BSidesCbr/BUSSide/(threads)

Thread 5 (2018-09-17):

No need to wait after Wire.requestFrom().

Koepel, 2018-09-17:
In the file "BUSSide/BUSSide/I2C.ino" the usage of `Wire.requestFrom()` and `Wire.available()` are used in a way as if `Wire.available()` waits for something.
The `Wire.requestFrom()` is blocking, it returns when the I2C transaction on the bus has finished. The `Wire.available()` returns the number of bytes in a buffer. There is no need to wait after the `Wire.requestFrom()`. This is the same for all Arduino Wire compatible libraries.
Explanation: [Common-mistakes#1](https://github.com/Koepel/How-to-use-the-Arduino-Wire-library/wiki/Common-mistakes#1)

About the function `read_I2C_eeprom()`:
The `ESP.wdtFeed();` is in the while-statement. But the `Wire.available()` and `Wire.read()` are fast. The `Wire.requestFrom()` is the one that takes time.

About the function `I2C_active_scan1()`:
When the `Wire.requestFrom()` does not return 8, the next slaveAddress is tested. The code after that (with the for-statement and the delay) is not really doing something, it falls through that code and executes the `ESP.wdtFeed();` and `numberOfSlaves++;`.

BSidesCbr, 2018-09-18:
Thank you. The fixes went in the last commit.

Closed 2018-09-18.

Thread 8 (2020-08-20):

Will this work on ESP32?

joanbono, 2020-08-20:
Just wondering if this will work on NodeMCU style board with WROOM32 chipset, which includes Bluetooth apart from WiFi.

Do you know if it’s compatible?

Thanks!

devec0, 2020-08-20:
I'm not sure it's been tested, and some of the GPIO names may need tweaking - but if it is supported by Arduino is could be made to work. If you have the board already, would be curious to see how you go compiling and uploading it with the ESP32 Arduino core.

joanbono, 2020-08-21:
I’m waiting for the board but I’ll look into it

devec0, 2022-02-09:
Going to close this for now but happy for a PR if you get it working.

Closed 2022-02-09.
