BSidesCbr/BUSSide/(commit log)

2018-04-14 Rename Hardware dir for compatibility with Arduino IDE
    The Arduino IDE requires sketches to be inside a folder with the same
    name as the sketch. The current directory name ("Hardware") causes an
    error on opening, and the IDE's default fix is to create a new dir and
    move only the BUSSide.ino file, breaking dependency file paths.
    [BUSSide.h, BUSSide.ino, I2C.ino, JTAG.ino, SPI.ino, UART.ino]
2018-08-25 Added UART tx detection and passhrough.
2018-08-25 NodeMCU code for UART passthrough and detection.
2018-08-26 New uart feature. Code cleanup.
    Moving code into bs.py
    uart passthrough auto is new command to combine the uart discovery and
    passthrough process.
2018-08-26 Fixup exception msg printing
    Correct printing
    [bs.py, bs_i2c.py, bs_jtag.py, bs_spi.py, bs_uart.py]
2018-08-26 i2c can do pinout discovery.
    New code to do i2c pinout discovery and do the other i2c functions with
    arbitrary GPIOs.
2018-09-17 I2C flashing and multi-size address support
    Add support for I2C flashing and allow multiple address sizes of 1 or 2
    bytes.
2018-09-18 New SPI features and I2C cleanup
    New features for SPI including pinout discovery, fuzzing/command
    enumeration, sending commands.
    Also bringing in code to prepare for writing to SPI flash.
    Fixing up a bug report by Koepel on incorrect use of available() in the
    I2C code.
    [BUSSide.h, BUSSide.ino, I2C.ino, SPI.ino, bs_spi.py, busside.py]
2018-09-20 Add more SPI support
    Support flashing via SPI. Also, a couple of extra commands such as read
    id, read unique id, and enable/disable write protection.
2018-09-24 Improve serial comms
    Non fixed size frames. Use a sync word. Improves reliability
    significantly.
    [BUSSide.h, BUSSide.ino, I2C.ino, JTAG.ino, SPI.ino, UART.ino, bs.py, bs_i2c.py]
2019-04-21 current arduiono ide doesn't like silvio's indents
    Arduino IDE ftbfs if function static property isn't on the same line
    as the function name.
    [BUSSide.ino, I2C.ino, JTAG.ino, SPI.ino, UART.ino]
2019-06-28 Changed shebang to portable python2
    When running newer distros that bundle python3 by default running './busside.py' will error out as it expects python3 code.
    Specifying the python version in the shebang allows './busside.py' to use python2 and the code will run as expected.
    /usr/bin/env is used so that python2 that is in the $PATH will be used to execute the file (it doesn't have to be in /usr/bin).
    [busside.py]
